riktw/LabPowerSupplyE361xA/README.md

# LabPowerSupplyE361xA
A E3611A based lab power supply with digital controls

More info on the corresponding [blog post.](https://justanotherelectronicsblog.com/?p=846)
