riktw/LabPowerSupplyE361xA/Kicad/Frontpanel/front_schematic.pdf

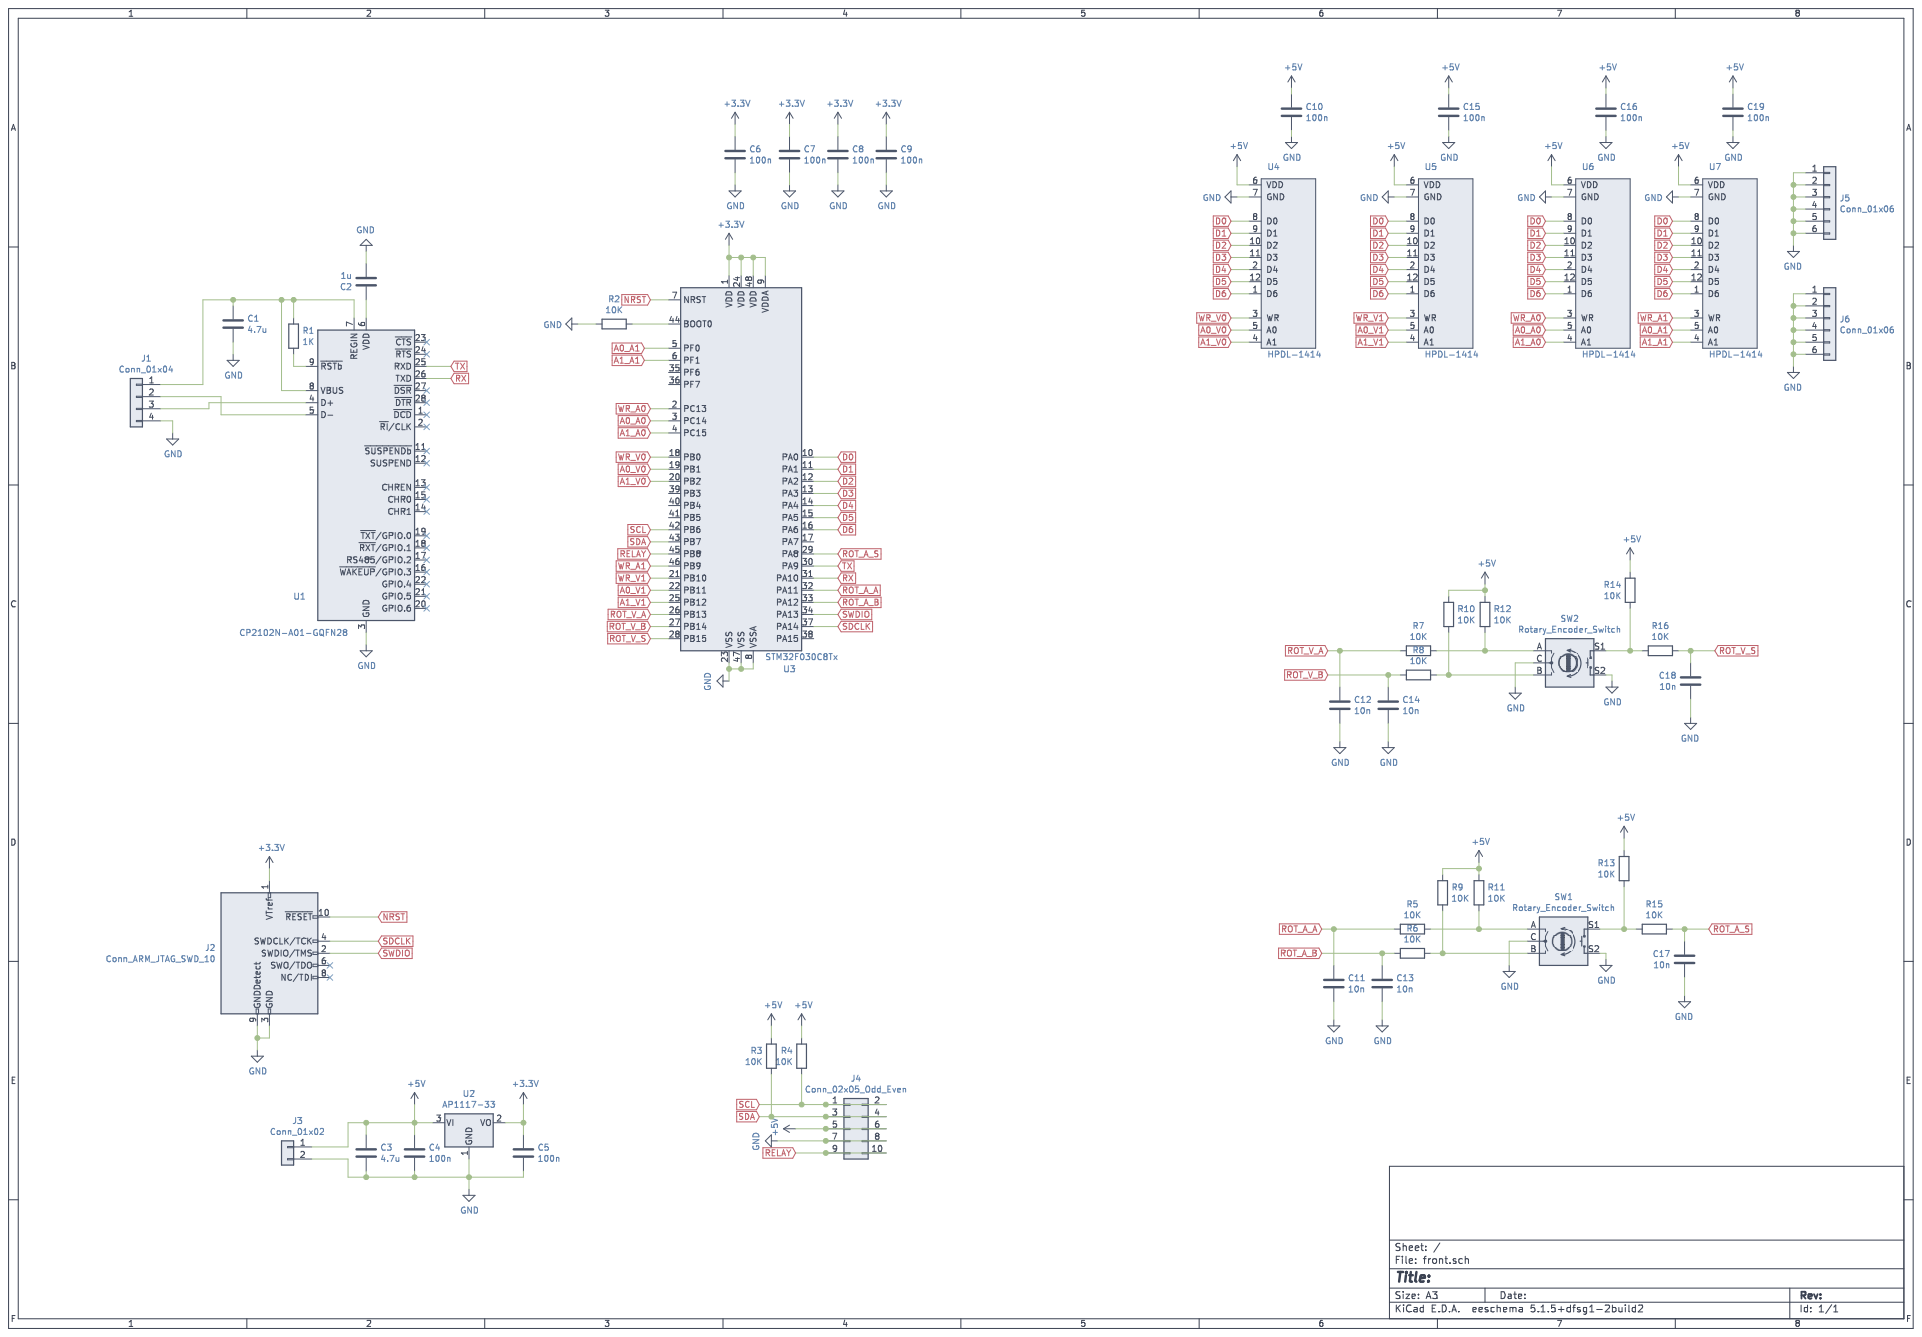
[picture p5: page 1]
