riktw/LabPowerSupplyE361xA/Ltspice/E3610A.asc

C3: cap; 18p
C4: cap; 2.2n
C5: cap; 6.8µ
C6: cap; 220µ
C9: cap; 220p
D1: diode; ES1D
D2: LED; NSCW100
D3: diode; 1N4148
D4: diode; 1N4148
D5: diode; 1N4148
D6: diode; 1N4148
D7: diode; 1N4148
D8: diode; 1N4148
D9: diode; MUR460
D10: LED; NSCW100
I1: current; 10mA
M1: nmos; IRF530
M2: nmos; IRF530
Q3: pnp; 2N3906
R1: res; 0.47
R2: res; 0.47
R3: res; 1K
R4: res; 1k
R5: res; 1k
R6: res; 1K
R7: res; 1k
R8: res; 1.2K
R9: res; 4.7K
R10: res; 1K
R11: res; 5K
R12: res; 1K
R13: res; 500
R14: res; 2.5K
R15: res; 650
R16: res; 3.3K
R17: res; 5k
R18: res; 39K
R19: res; 4.7K
R20: res; 100K
R21: res; 1500K
R22: res; 1
R23: res; 155
R24: res; 560
R25: res; 250
R26: res; 22
R27: res; 1k
R28: res; 1k
R29: res; 1k
R30: res; 0.2
R31: res; 100K
R35: res; 2.5K
R36: res; 50K
R37: res; 2.5K
U1: LT1002
U2: LT1002
U3: LT1002
U4: LT1634-5
U5: LT1002
U6: LT1011
U7: LT1011
V1: voltage; SINE(40 1 100)
V2: voltage; 12
V3: voltage; 12
Named nets: +12, +5, -12, S+, 0
.tran 0 0.1 0 1u
6.8 of 2.2u maakt snelheid anders
CC mode
CV mode
R15, R13, 5K or 10K adj pot
