riktw/LabPowerSupplyE361xA/Ltspice/E3610A_simple.asc

C6: cap; 220µ
D1: diode; ES1D
D3: diode; 1N4148
D4: diode; 1N4148
M1: nmos; IRF530
Q3: pnp; 2N3906
R8: res; 1.2K
R9: res; 4.7K
R12: res; 1K
R16: res; 3.9K
R17: res; 2500
R22: res; 5000
R23: res; 715
R25: res; 2500
R30: res; 0.2
R35: res; 2.5K
R36: res; 50K
R37: res; 2.5K
U1: LT1002
U2: LT1002
U3: LT1002
U4: LT1634-5
U5: LT1002
V1: voltage; SINE(40 1 100)
V2: voltage; 12
V3: voltage; 12
Named nets: +12, -12, 0, OUTPUT, REF5V
.tran 0 0.05 0 1u uic
0-5K for voltage control
0-5K for current control
