riktw/LabPowerSupplyE361xA/Kicad/Frontpanel/front.kicad_pcb

## KiCad design Kicad/Frontpanel/front.kicad_pcb (2021-09-05)

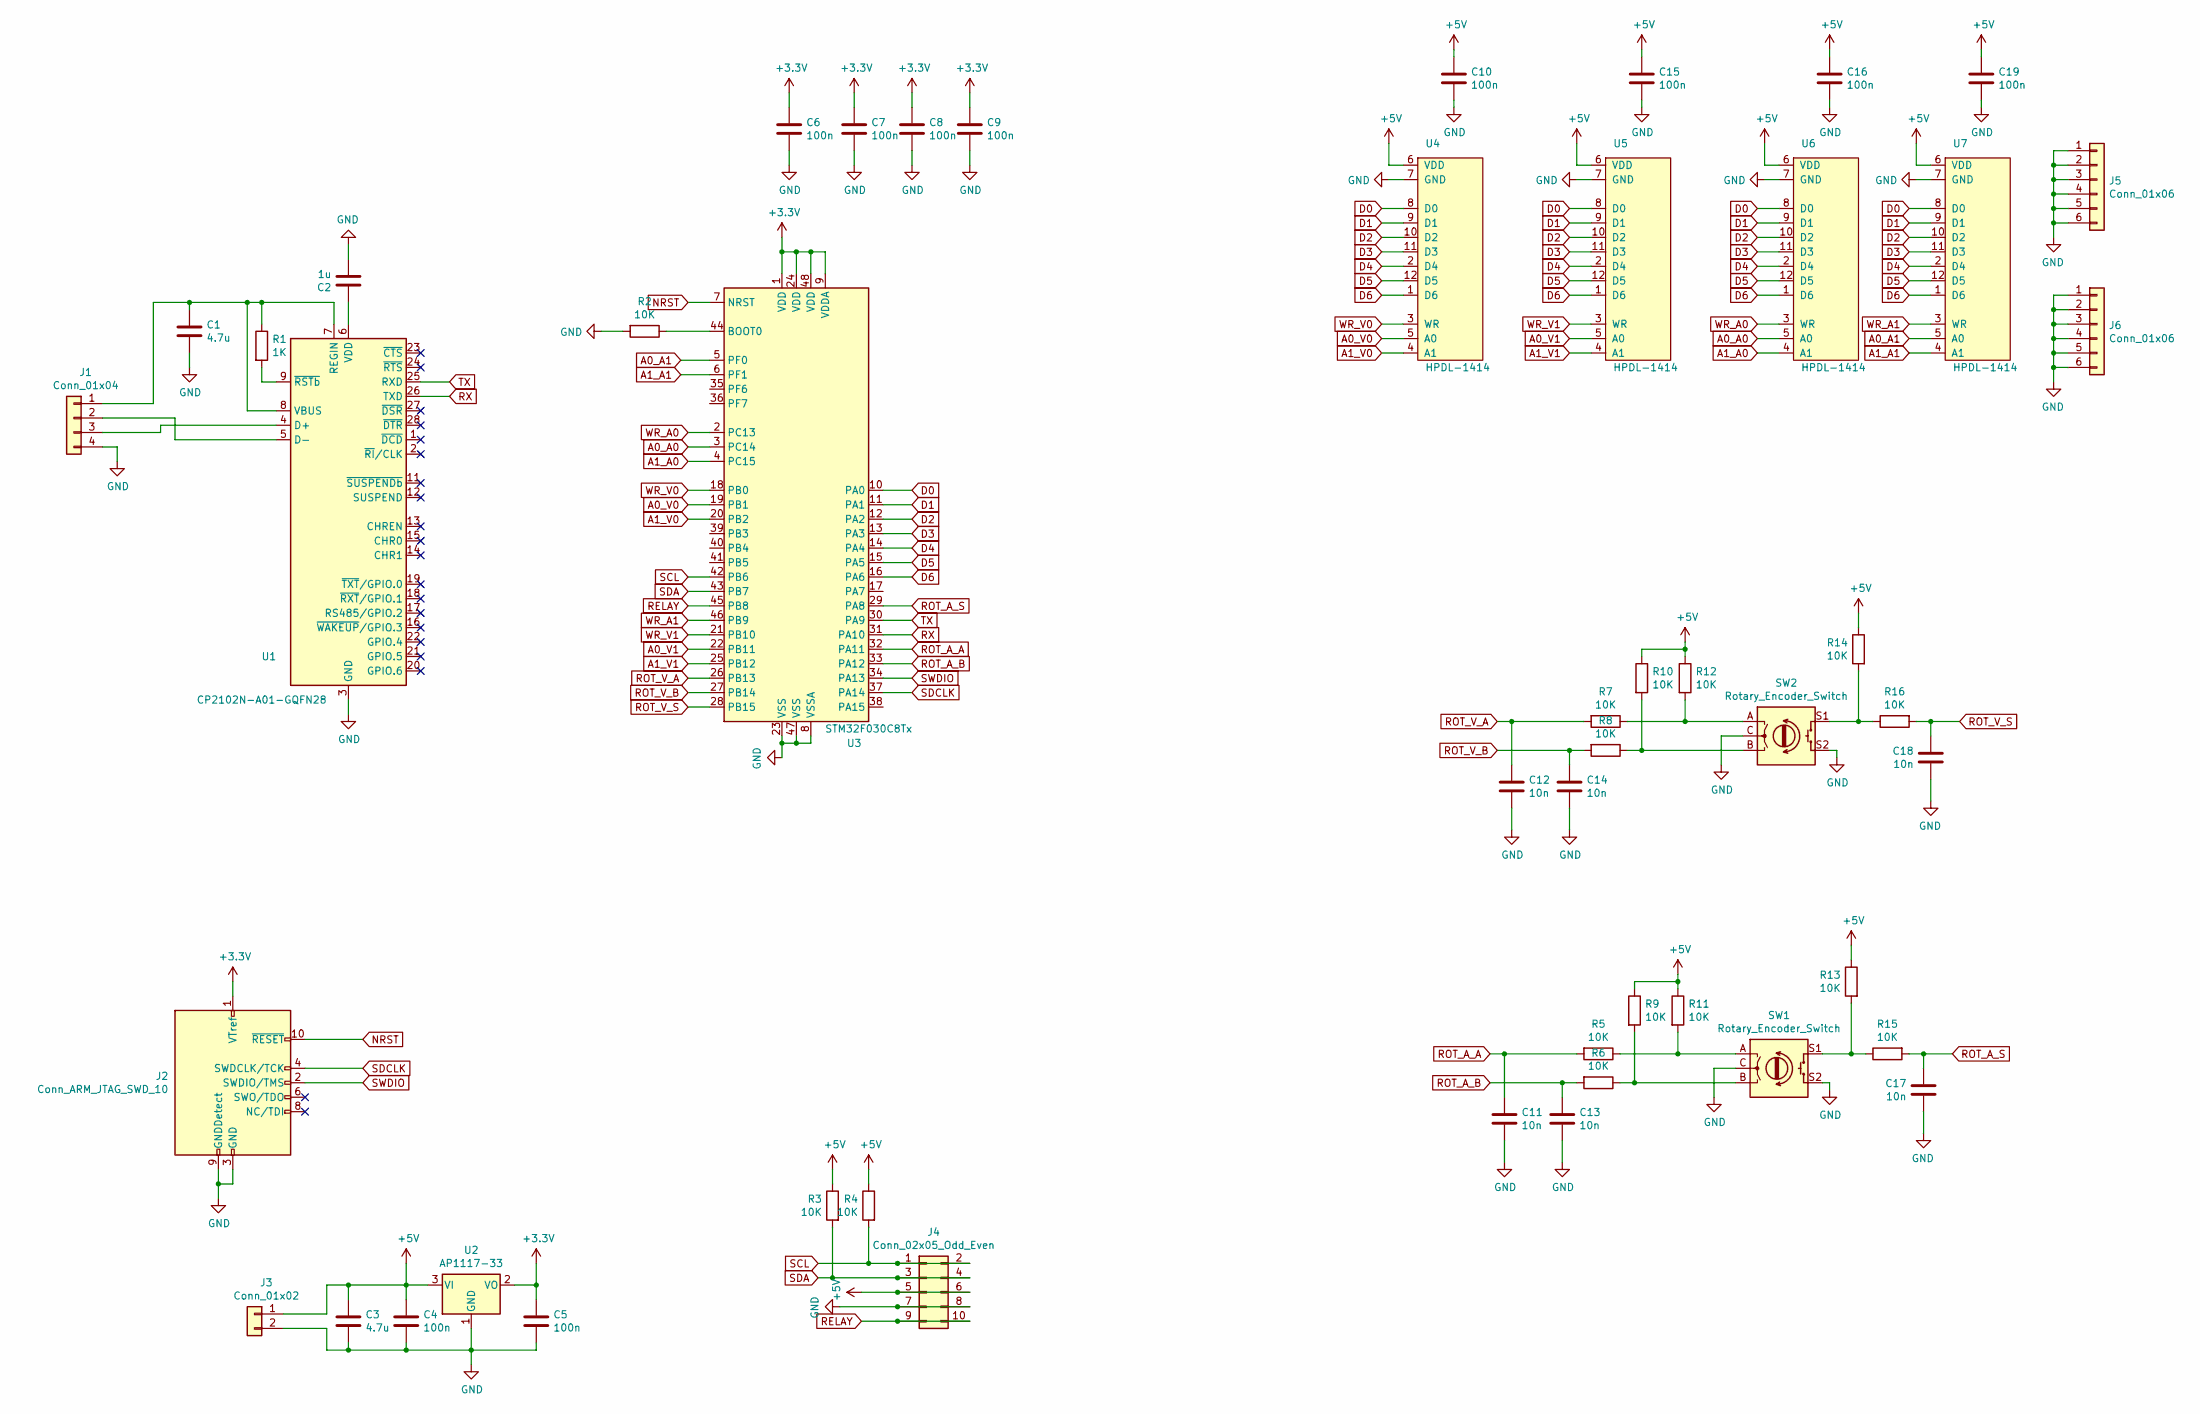
[picture p6: schematic front.sch]

Parts:
C1, C3: 4.7u; C_0603_1608Metric_Pad1.05x0.95mm_HandSolder
C2: 1u; C_0603_1608Metric_Pad1.05x0.95mm_HandSolder
C4, C5, C6, C7, C8, C9, C10, C15, C16, C19: 100n; C_0603_1608Metric_Pad1.05x0.95mm_HandSolder
C11, C12, C13, C14, C17, C18: 10n; C_0603_1608Metric_Pad1.05x0.95mm_HandSolder
J1: Conn_01x04; PinHeader_1x04_P2.54mm_Vertical
J2: Conn_ARM_JTAG_SWD_10; PinHeader_2x05_P1.27mm_Vertical_SMD
J3: Conn_01x02; Wago_734-132_1x02_P3.50mm_Vertical
J4: Conn_02x05_Odd_Even; IDC-Header_2x05_P2.54mm_Vertical
J5, J6: Conn_01x06; PinSocket_1x06_P2.54mm_Vertical
R1: 1K; R_0603_1608Metric_Pad1.05x0.95mm_HandSolder
R2, R3, R4, R5, R6, R7, R8, R9, R10, R11, R12, R13, R14, R15, R16: 10K; R_0603_1608Metric_Pad1.05x0.95mm_HandSolder
SW1, SW2: Rotary_Encoder_Switch; RotaryEncoder_Alps_EC11E-Switch_Vertical_H20mm
U1: CP2102N-A01-GQFN28; QFN-28-1EP_5x5mm_P0.5mm_EP3.35x3.35mm; JLC C6568
U2: AP1117-33; SOT-223-3_TabPin2
U3: STM32F030C8Tx; LQFP-48_7x7mm_P0.5mm
U4, U5, U6, U7: HPDL-1414

Connections:
+3V3: C5.1, C6.1, C7.1, C8.1, C9.1, J2.1 (VTref), U2.2 (VO), U3.1 (VDD), U3.9 (VDDA), U3.24 (VDD), U3.48 (VDD)
+5V: C3.1, C4.1, C10.1, C15.1, C16.1, C19.1, J3.1, J4.5, J4.6, R3.1, R4.1, R9.1, R10.1, R11.1, R12.1, R13.1, R14.1, U2.3 (VI), U4.6 (VDD), U5.6 (VDD), U6.6 (VDD), U7.6 (VDD)
A0_A0: U3.3 (PC14), U6.5 (A0)
A0_A1: U3.5 (PF0), U7.5 (A0)
A0_V0: U3.19 (PB1), U4.5 (A0)
A0_V1: U3.22 (PB11), U5.5 (A0)
A1_A0: U3.4 (PC15), U6.4 (A1)
A1_A1: U3.6 (PF1), U7.4 (A1)
A1_V0: U3.20 (PB2), U4.4 (A1)
A1_V1: U3.25 (PB12), U5.4 (A1)
D0: U3.10 (PA0), U4.8 (D0), U5.8 (D0), U6.8 (D0), U7.8 (D0)
D1: U3.11 (PA1), U4.9 (D1), U5.9 (D1), U6.9 (D1), U7.9 (D1)
D2: U3.12 (PA2), U4.10 (D2), U5.10 (D2), U6.10 (D2), U7.10 (D2)
D3: U3.13 (PA3), U4.11 (D3), U5.11 (D3), U6.11 (D3), U7.11 (D3)
D4: U3.14 (PA4), U4.2 (D4), U5.2 (D4), U6.2 (D4), U7.2 (D4)
D5: U3.15 (PA5), U4.12 (D5), U5.12 (D5), U6.12 (D5), U7.12 (D5)
D6: U3.16 (PA6), U4.1 (D6), U5.1 (D6), U6.1 (D6), U7.1 (D6)
GND: C1.2, C2.2, C3.2, C4.2, C5.2, C6.2, C7.2, C8.2, C9.2, C10.2, C11.2, C12.2, C13.2, C14.2, C15.2, C16.2, C17.2, C18.2, C19.2, J1.4, J2.3 (GND), J2.5 (GND), J2.9 (GNDDetect), J3.2, J4.7, J4.8, J5.1, J5.2, J5.3, J5.4, J5.5, J5.6, J6.1, J6.2, J6.3, J6.4, J6.5, J6.6, R2.2, SW1.C, SW1.S2, SW2.C, SW2.S2, U1.3 (GND), U1.29 (GND), U2.1 (GND), U3.8 (VSSA), U3.23 (VSS), U3.47 (VSS), U4.7 (GND), U5.7 (GND), U6.7 (GND), U7.7 (GND)
NRST: J2.10 (~RESET~), U3.7 (NRST)
unnamed: C1.1, J1.1, R1.1, U1.7 (REGIN), U1.8 (VBUS)
unnamed: C2.1, U1.6 (VDD)
unnamed: J1.2, U1.5 (D-)
unnamed: J1.3, U1.4 (D+)
unnamed: R1.2, U1.9 (~RSTb)
unnamed: R2.1, U3.44 (BOOT0)
unnamed: R6.1, R9.2, SW1.B
unnamed: R8.1, R10.2, SW2.B
unnamed: R5.1, R11.2, SW1.A
unnamed: R7.1, R12.2, SW2.A
unnamed: R13.2, R15.1, SW1.S1
unnamed: R14.2, R16.1, SW2.S1
RELAY: J4.9, J4.10, U3.45 (PB8)
ROT_A_A: C11.1, R5.2, U3.32 (PA11)
ROT_A_B: C13.1, R6.2, U3.33 (PA12)
ROT_A_S: C17.1, R15.2, U3.29 (PA8)
ROT_V_A: C12.1, R7.2, U3.26 (PB13)
ROT_V_B: C14.1, R8.2, U3.27 (PB14)
ROT_V_S: C18.1, R16.2, U3.28 (PB15)
RX: U1.26 (TXD), U3.31 (PA10)
SCL: J4.1, J4.2, R4.2, U3.42 (PB6)
SDA: J4.3, J4.4, R3.2, U3.43 (PB7)
SDCLK: J2.4 (SWDCLK/TCK), U3.37 (PA14)
SWDIO: J2.2 (SWDIO/TMS), U3.34 (PA13)
TX: U1.25 (RXD), U3.30 (PA9)
WR_A0: U3.2 (PC13), U6.3 (WR)
WR_A1: U3.46 (PB9), U7.3 (WR)
WR_V0: U3.18 (PB0), U4.3 (WR)
WR_V1: U3.21 (PB10), U5.3 (WR)

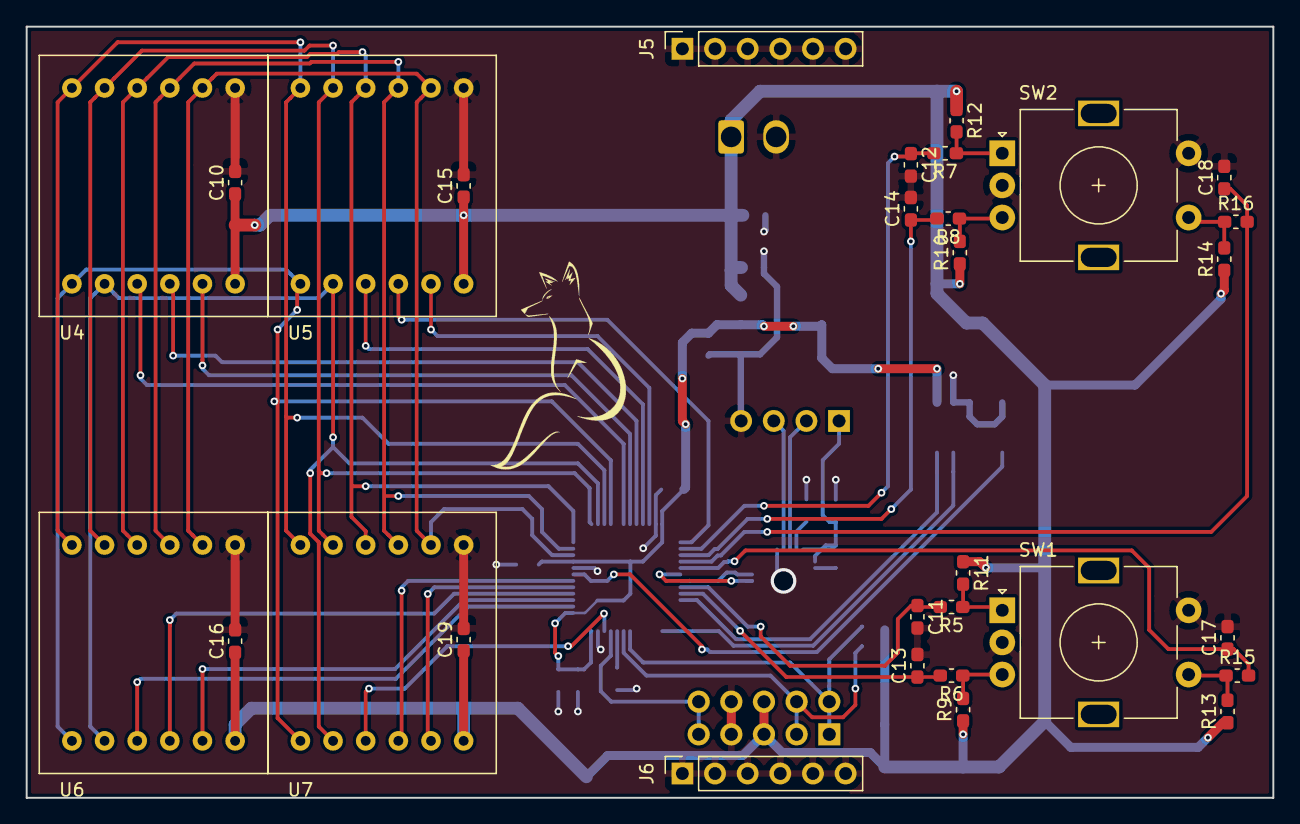
[picture p7: board front.kicad_pcb from above]

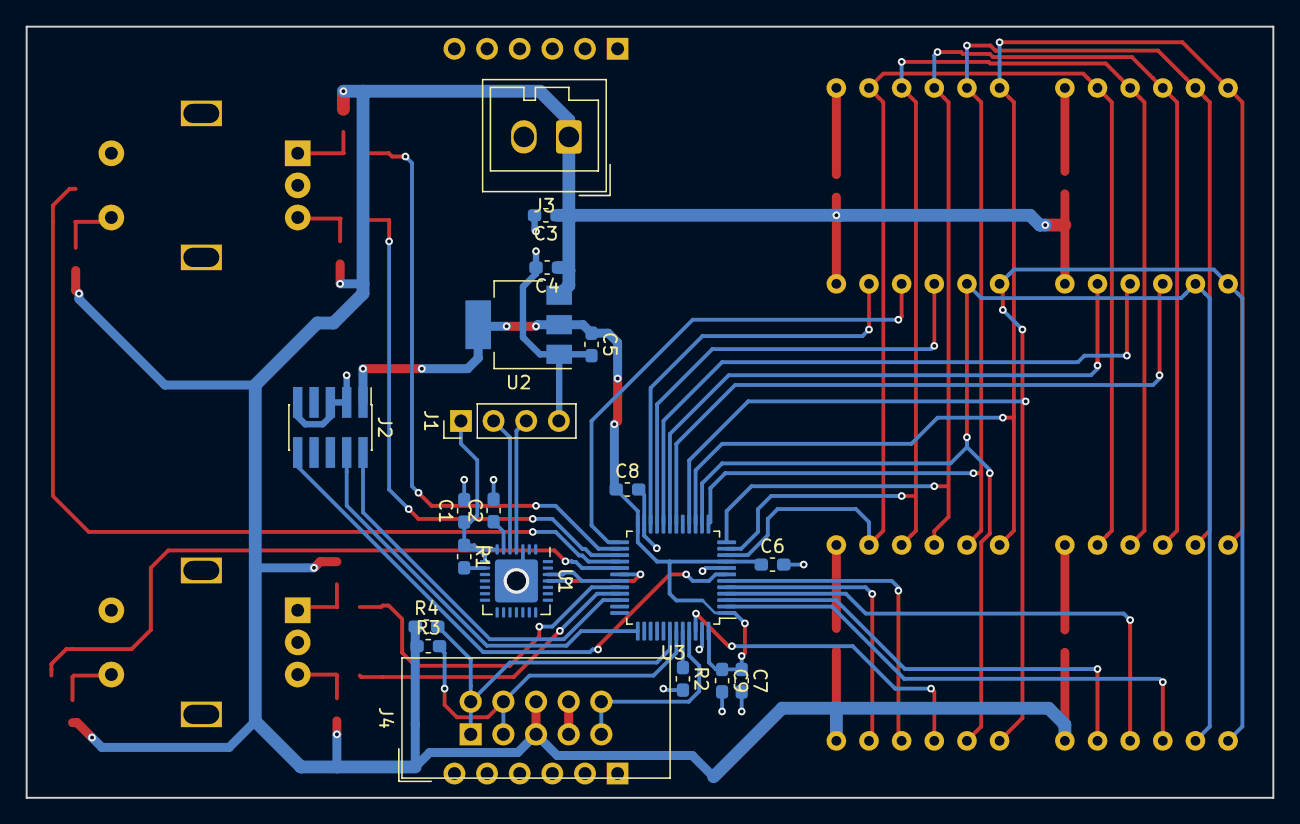
[picture p8: board front.kicad_pcb from below]

Board: 2 copper layers, 97.0 x 60.0 mm, 50 parts (20 on the bottom side), 48 nets.
