riktw/LabPowerSupplyE361xA/Kicad/E3611Abased.kicad_pcb

## KiCad design Kicad/E3611Abased.kicad_pcb (2021-09-05)

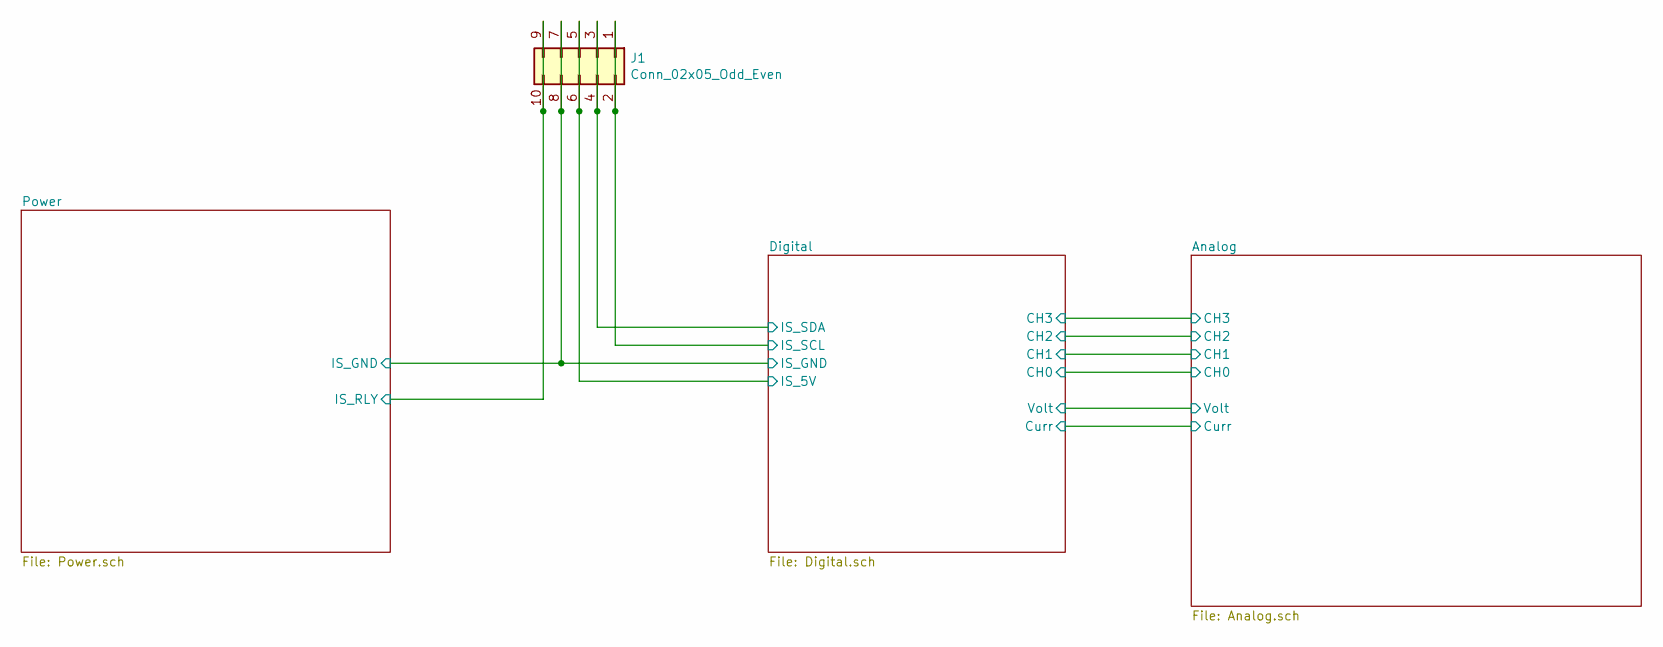
[picture p9: schematic E3611Abased.sch]

Parts:
J1: Conn_02x05_Odd_Even; IDC-Header_2x05_P2.54mm_Vertical

Connections:
/Digital/IS_5V: J1.5, J1.6; also elsewhere on the board
/Digital/IS_GND: J1.7, J1.8; also elsewhere on the board
/Digital/IS_SCL: J1.1, J1.2; also elsewhere on the board
/Digital/IS_SDA: J1.3, J1.4; also elsewhere on the board
/Power/IS_RLY: J1.9, J1.10; also elsewhere on the board

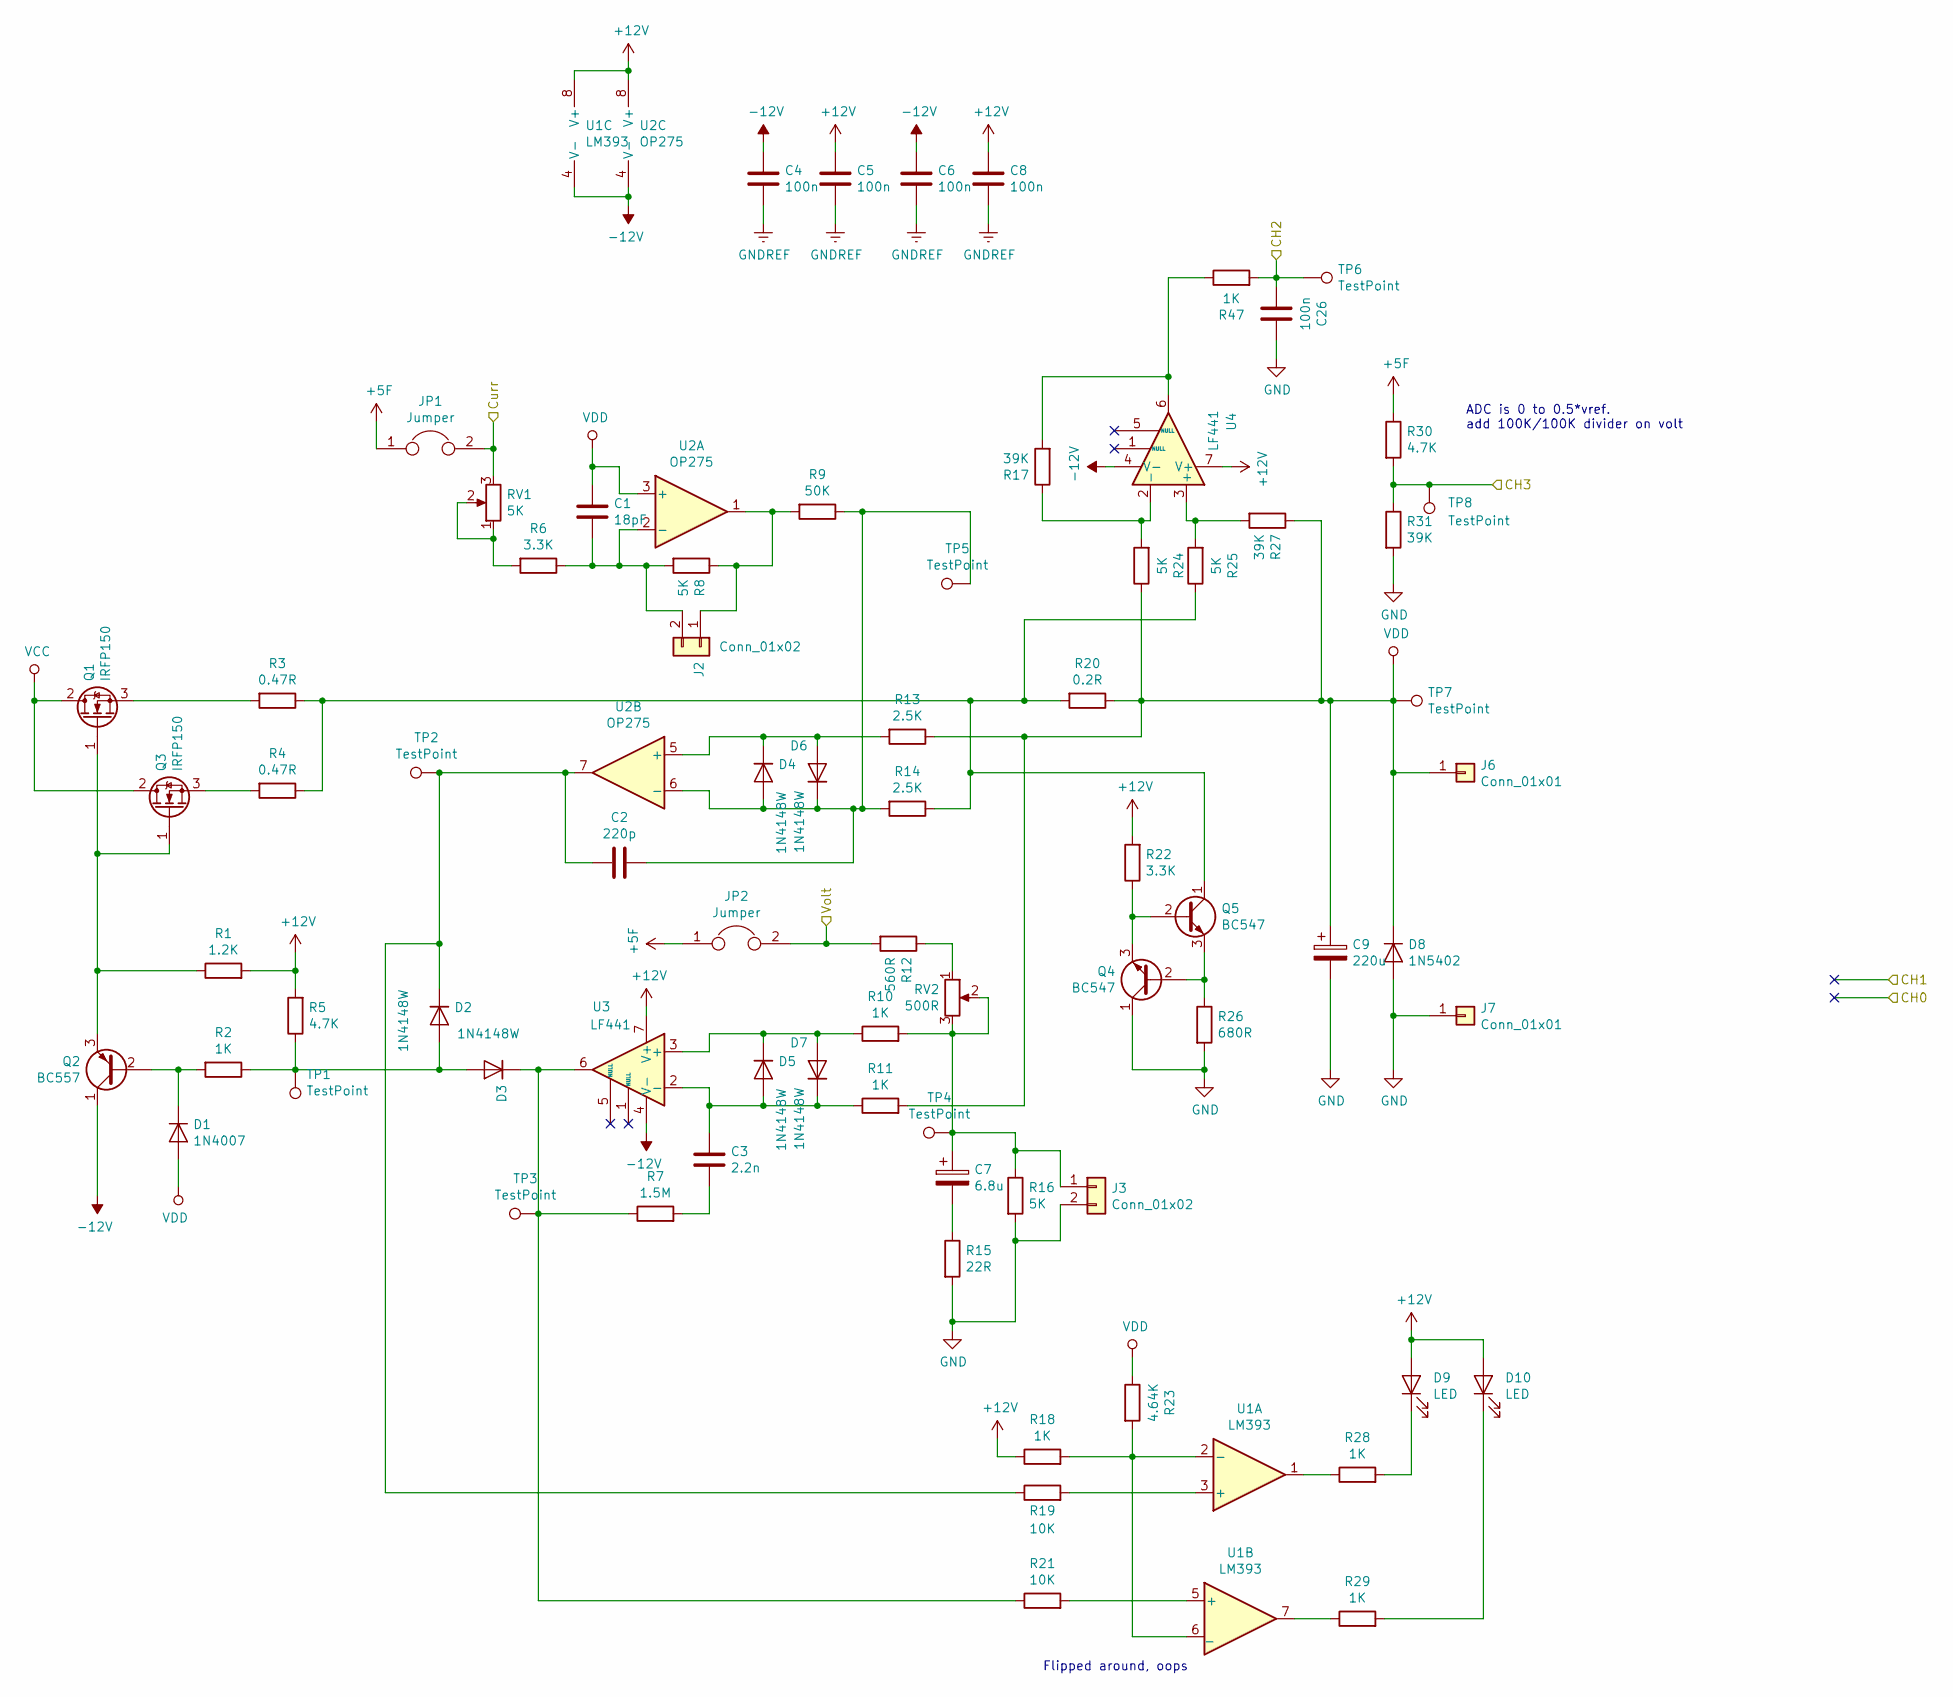
[picture p10: schematic Analog.sch]

Parts:
C1: 18pF; C_0603_1608Metric_Pad1.05x0.95mm_HandSolder
C2: 220p; C_0603_1608Metric_Pad1.05x0.95mm_HandSolder
C3: 2.2n; C_0603_1608Metric_Pad1.05x0.95mm_HandSolder
C4, C5, C6, C8, C26: 100n; C_0603_1608Metric_Pad1.05x0.95mm_HandSolder
C7: 6.8u; CP_Elec_6.3x3
C9: 220u; CP_Radial_D10.0mm_P5.00mm
D1: 1N4007; D_DO-41_SOD81_P10.16mm_Horizontal
D2, D3, D4, D5, D6, D7: 1N4148W; D_SOD-123
D8: 1N5402; D_DO-201AD_P15.24mm_Horizontal
D9, D10: LED; LED_D5.0mm
J2, J3: Conn_01x02; TerminalBlock_Phoenix_MKDS-1,5-2-5.08_1x02_P5.08mm_Horizont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
J6, J7: Conn_01x01; 24.243_Banana_plug
JP1, JP2: Jumper; SolderJumper-2_P1.3mm_Open_Pad1.0x1.5mm
Q1, Q3: IRFP150; TO-247-3_Vertical
Q2: BC557; TO-92_Inline
Q4, Q5: BC547; TO-92_Inline
R1: 1.2K; R_0603_1608Metric_Pad1.05x0.95mm_HandSolder
R2, R10, R11, R18, R28, R29, R47: 1K; R_0603_1608Metric_Pad1.05x0.95mm_HandSolder
R3, R4: 0.47R; R_Axial_DIN0207_L6.3mm_D2.5mm_P15.24mm_Horizontal
R5, R30: 4.7K; R_0603_1608Metric_Pad1.05x0.95mm_HandSolder
R6, R22: 3.3K; R_0603_1608Metric_Pad1.05x0.95mm_HandSolder
R7: 1.5M; R_0603_1608Metric_Pad1.05x0.95mm_HandSolder
R8, R16, R24, R25: 5K; R_0603_1608Metric_Pad1.05x0.95mm_HandSolder
R9: 50K; R_0603_1608Metric_Pad1.05x0.95mm_HandSolder
R12: 560R; R_0603_1608Metric_Pad1.05x0.95mm_HandSolder
R13, R14: 2.5K; R_0603_1608Metric_Pad1.05x0.95mm_HandSolder
R15: 22R; R_0603_1608Metric_Pad1.05x0.95mm_HandSolder
R17, R27, R31: 39K; R_0603_1608Metric_Pad1.05x0.95mm_HandSolder
R19, R21: 10K; R_0603_1608Metric_Pad1.05x0.95mm_HandSolder
R20: 0.2R; R_Axial_DIN0207_L6.3mm_D2.5mm_P15.24mm_Horizontal
R23: 4.64K; R_0603_1608Metric_Pad1.05x0.95mm_HandSolder
R26: 680R; R_0603_1608Metric_Pad1.05x0.95mm_HandSolder
RV1: 5K; Potentiometer_Bourns_3266Y_Vertical
RV2: 500R; Potentiometer_Bourns_3266Y_Vertical
TP1, TP2, TP3, TP4, TP5, TP6, TP7, TP8: TestPoint; TestPoint_Loop_D1.80mm_Drill1.0mm_Beaded
U1: LM393; SOIC-8_3.9x4.9mm_P1.27mm
U2: OP275; SOIC-8_3.9x4.9mm_P1.27mm
U3, U4: LF441; SOIC-8_3.9x4.9mm_P1.27mm

Connections:
+5F: JP1.1, JP2.1, R30.1; also elsewhere on the board
+12V: C5.1, C8.1, D9.2 (A), D10.2 (A), R1.2, R5.2, R18.1, R22.2, U1.8 (V+), U2.8 (V+), U3.7 (V+), U4.7 (V+); also elsewhere on the board
-12V: C4.1, C6.1, Q2.1 (C), U1.4 (V-), U2.4 (V-), U3.4 (V-), U4.4 (V-); also elsewhere on the board
/Analog/CH2: C26.2, R47.2, TP6.1; also elsewhere on the board
/Analog/CH3: R30.2, R31.1, TP8.1; also elsewhere on the board
/Analog/Curr: JP1.2, RV1.3; also elsewhere on the board
/Analog/Volt: JP2.2, R12.2; also elsewhere on the board
GND: C9.2, C26.1, D8.2 (A), J3.2, J7.1, Q4.1 (C), R15.2, R16.2, R26.2, R31.2; also elsewhere on the board
GNDREF: C1.1, C4.2, C5.2, C6.2, C8.2, C9.1, D1.2 (A), D8.1 (K), J6.1, R11.2, R13.1, R20.1, R23.1, R24.1, R27.1, TP7.1, U2.3 (+); also elsewhere on the board
unnamed: C1.2, J2.2, R6.1, R8.2, U2.2 (-)
unnamed: C2.1, D4.2 (A), D6.1 (K), R9.1, R14.2, TP5.1, U2.6 (-)
unnamed: C2.2, D2.1 (K), R19.1, TP2.1, U2.7
unnamed: C3.1, D5.2 (A), D7.1 (K), R11.1, U3.2 (-)
unnamed: C3.2, R7.2
unnamed: C7.1, J3.1, R10.2, R16.1, RV2.2, RV2.3, TP4.1
unnamed: C7.2, R15.1
unnamed: D1.1 (K), Q2.2 (B), R2.2
unnamed: D2.2 (A), D3.2 (A), R2.1, R5.1, TP1.1
unnamed: D3.1 (K), R7.1, R21.1, TP3.1, U3.6
unnamed: D4.1 (K), D6.2 (A), R13.2, U2.5 (+)
unnamed: D5.1 (K), D7.2 (A), R10.1, U3.3 (+)
unnamed: D9.1 (K), R28.2
unnamed: D10.1 (K), R29.2
unnamed: J2.1, R8.1, R9.2, U2.1
unnamed: Q1.1 (G), Q2.3 (E), Q3.1 (G), R1.1
unnamed: Q1.3 (S), R3.2
unnamed: Q3.3 (S), R4.2
unnamed: Q4.2 (B), Q5.3 (E), R26.1
unnamed: Q4.3 (E), Q5.2 (B), R22.1
unnamed: Q5.1 (C), R3.1, R4.1, R14.1, R20.2, R25.1
unnamed: R6.2, RV1.1, RV1.2
unnamed: R12.1, RV2.1
unnamed: R17.1, R24.2, U4.2 (-)
unnamed: R17.2, R47.1, U4.6
unnamed: R18.2, R23.2, U1.2 (-), U1.6 (_)
unnamed: R19.2, U1.3 (+)
unnamed: R21.2, U1.5 (+)
unnamed: R25.2, R27.2, U4.3 (+)
unnamed: R28.1, U1.1
unnamed: R29.1, U1.7
VCC: Q1.2 (D), Q3.2 (D); also elsewhere on the board

Notes on the sheet:
ADC is 0 to 0.5*vref. add 100K/100K divider on volt
Flipped around, oops

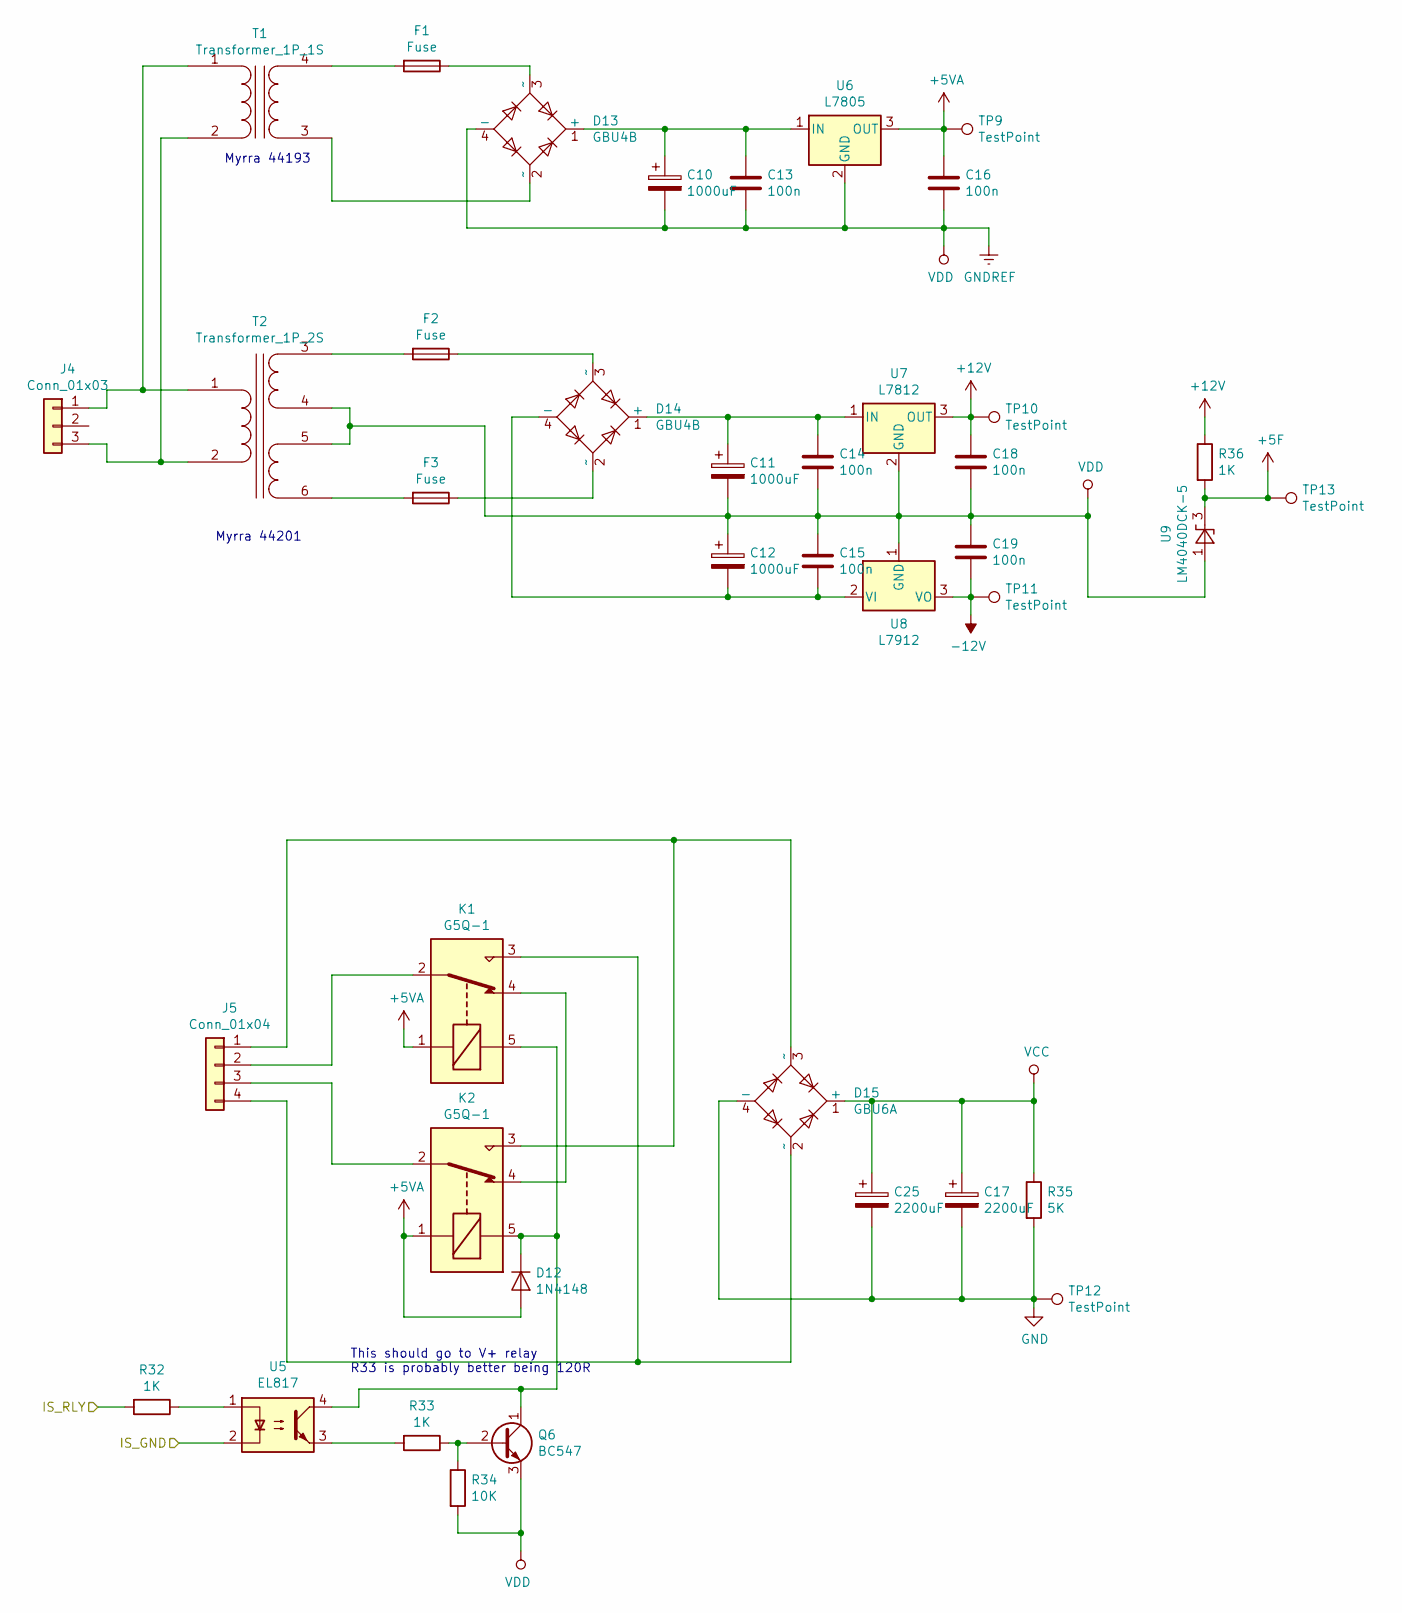
[picture p11: schematic Power.sch]

Parts:
C10, C11, C12: 1000uF; CP_Radial_D10.0mm_P5.00mm
C13, C14, C15, C16, C18, C19: 100n; C_Disc_D5.0mm_W2.5mm_P5.00mm
C17, C25: 2200uF; CP_Radial_D18.0mm_P7.50mm
D12: 1N4148; D_DO-35_SOD27_P7.62mm_Horizontal
D13, D14: GBU4B; Diode_Bridge_Vishay_GBU
D15: GBU6A; Diode_Bridge_Vishay_GBU
F1, F2, F3: Fuse; Fuseholder_Cylinder-5x20mm_Stelvio-Kontek_PTF78_Horizontal_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
J4: Conn_01x03; TerminalBlock_Phoenix_MKDS-1,5-3-5.08_1x03_P5.08mm_Horizont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
J5: Conn_01x04; TerminalBlock_Phoenix_MKDS-1,5-4-5.08_1x04_P5.08mm_Horizont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
K1, K2: G5Q-1; Relay_SPDT_Omron-G5Q-1
Q6: BC547; TO-92_Inline
R32, R33: 1K; R_0603_1608Metric_Pad1.05x0.95mm_HandSolder
R34: 10K; R_0603_1608Metric_Pad1.05x0.95mm_HandSolder
R35: 5K; R_Axial_DIN0414_L11.9mm_D4.5mm_P15.24mm_Horizontal
R36: 1K; R_0603_1608Metric
T1: Transformer_1P_1S; 44XXX_Transformer_3.2VA_Single
T2: Transformer_1P_2S; 44XXX_Transformer_3.2VA
TP9, TP10, TP11, TP12, TP13: TestPoint; TestPoint_Loop_D1.80mm_Drill1.0mm_Beaded
U5: EL817; DIP-4_W7.62mm
U6: L7805; TO-220-3_Vertical
U7: L7812; TO-220-3_Vertical
U8: L7912; TO-220-3_Vertical
U9: LM4040DCK-5; SOT-353_SC-70-5

Connections:
+5F: R36.2, TP13.1, U9.3 (K); also elsewhere on the board
+5VA: C16.1, D12.2 (A), K1.1, K2.1, TP9.1, U6.3 (OUT); also elsewhere on the board
+12V: C18.1, R36.1, TP10.1, U7.3 (OUT); also elsewhere on the board
-12V: C19.2, TP11.1, U8.3 (VO); also elsewhere on the board
/Digital/IS_GND: U5.2; also elsewhere on the board
/Power/IS_RLY: R32.2; also elsewhere on the board
GND: C17.2, C25.2, D15.4 (-), R35.2, TP12.1; also elsewhere on the board
GNDREF: C10.2, C11.2, C12.1, C13.2, C14.2, C15.1, C16.2, C18.2, C19.1, D13.4 (-), Q6.3 (E), R34.2, T2.4 (SB), T2.5 (SC), U6.2 (GND), U7.2 (GND), U8.1 (GND), U9.1 (A); also elsewhere on the board
unnamed: C10.1, C13.1, D13.1 (+), U6.1 (IN)
unnamed: C11.1, C14.1, D14.1 (+), U7.1 (IN)
unnamed: C12.2, C15.2, D14.4 (-), U8.2 (VI)
unnamed: D12.1 (K), K1.5, K2.5, Q6.1 (C), U5.4
unnamed: D13.2 (~~), T1.3 (SA)
unnamed: D13.3 (~~), F1.1
unnamed: D14.2 (~~), F3.1
unnamed: D14.3 (~~), F2.1
unnamed: D15.2 (~~), J5.4, K1.3
unnamed: D15.3 (~~), J5.1, K2.3
unnamed: F1.2, T1.4 (SB)
unnamed: F2.2, T2.3 (SA)
unnamed: F3.2, T2.6 (SD)
unnamed: J4.1, T1.1 (AA), T2.1 (AA)
unnamed: J4.3, T1.2 (AB), T2.2 (AB)
unnamed: J5.2, K1.2
unnamed: J5.3, K2.2
unnamed: K1.4, K2.4
unnamed: Q6.2 (B), R33.1, R34.1
unnamed: R32.1, U5.1
unnamed: R33.2, U5.3
VCC: C17.1, C25.1, D15.1 (+), R35.1; also elsewhere on the board

Notes on the sheet:
Myrra 44201
Myrra 44193
This should go to V+ relay R33 is probably better being 120R

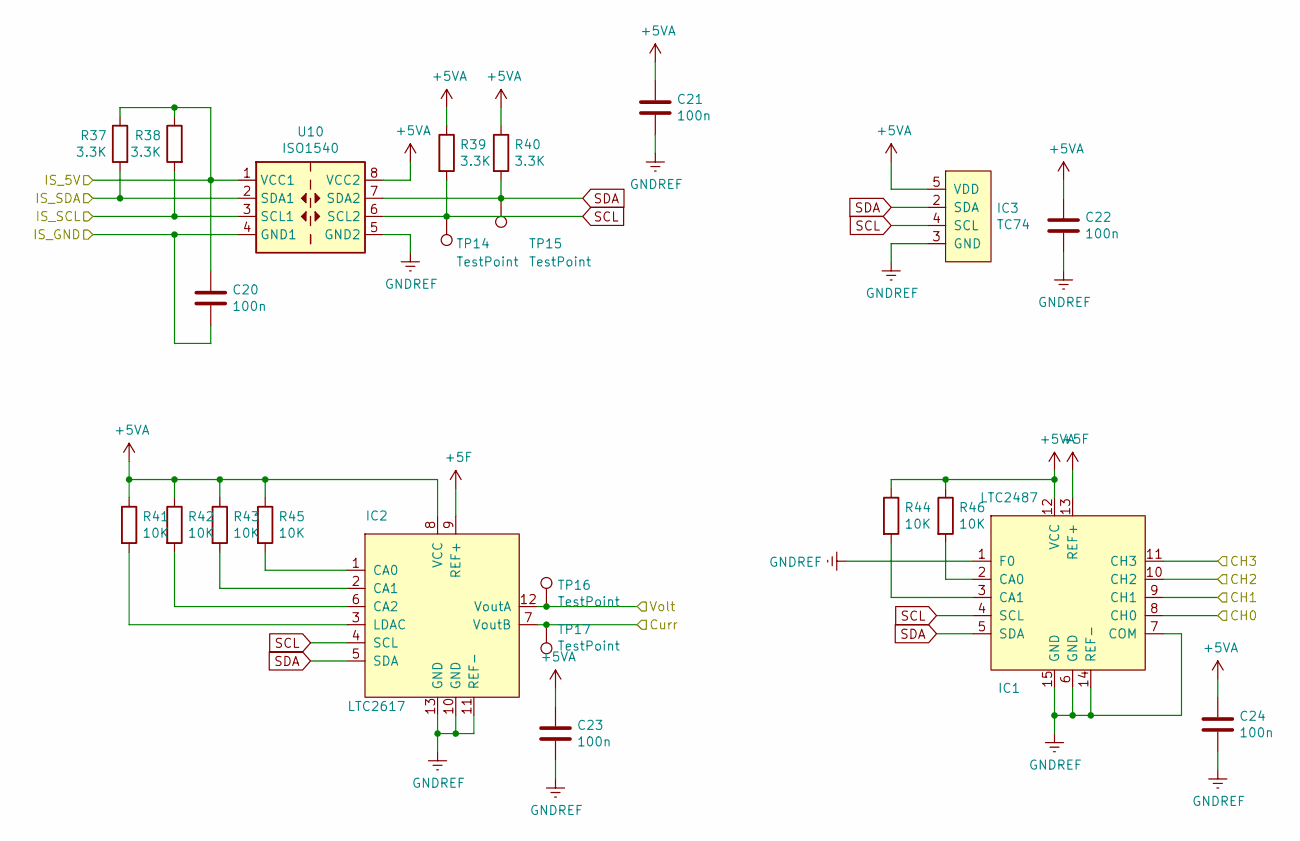
[picture p12: schematic Digital.sch]

Parts:
C20, C21, C22, C23, C24: 100n; C_0603_1608Metric_Pad1.05x0.95mm_HandSolder
IC1: LTC2487; DFN-14-1EP_3x4mm_P0.5mm_EP1.7x3.3mm
IC2: LTC2617; DFN-12-1EP_3x4mm_P0.5mm_EP1.7x3.3mm
IC3: TC74; TO-220-5_Vertical
R37, R38, R39, R40: 3.3K; R_0603_1608Metric
R41, R42, R43, R44, R45, R46: 10K; R_0603_1608Metric
TP14, TP15, TP16, TP17: TestPoint; TestPoint_Loop_D1.80mm_Drill1.0mm_Beaded
U10: ISO1540; SOIC-8_3.9x4.9mm_P1.27mm

Connections:
+5F: IC1.13 (REF+), IC2.9 (REF+); also elsewhere on the board
+5VA: C21.1, C22.1, C23.1, C24.1, IC1.12 (VCC), IC2.8 (VCC), IC3.5 (VDD), R39.1, R40.1, R41.1, R42.1, R43.1, R44.1, R45.1, R46.1, U10.8 (VCC2); also elsewhere on the board
/Analog/CH0: IC1.8 (CH0)
/Analog/CH1: IC1.9 (CH1)
/Analog/CH2: IC1.10 (CH2); also elsewhere on the board
/Analog/CH3: IC1.11 (CH3); also elsewhere on the board
/Analog/Curr: IC2.7 (VoutB), TP17.1; also elsewhere on the board
/Analog/Volt: IC2.12 (VoutA), TP16.1; also elsewhere on the board
/Digital/IS_5V: C20.1, R37.1, R38.1, U10.1 (VCC1); also elsewhere on the board
/Digital/IS_GND: C20.2, U10.4 (GND1); also elsewhere on the board
/Digital/IS_SCL: R38.2, U10.3 (SCL1); also elsewhere on the board
/Digital/IS_SDA: R37.2, U10.2 (SDA1); also elsewhere on the board
GNDREF: C21.2, C22.2, C23.2, C24.2, IC1.1 (F0), IC1.6 (GND), IC1.7 (COM), IC1.14 (REF-), IC1.15 (GND), IC2.10 (GND), IC2.11 (REF-), IC2.13 (GND), IC3.3 (GND), U10.5 (GND2); also elsewhere on the board
unnamed: IC1.2 (CA0), R46.2
unnamed: IC1.3 (CA1), R44.2
unnamed: IC2.1 (CA0), R45.2
unnamed: IC2.2 (CA1), R43.2
unnamed: IC2.3 (LDAC), R41.2
unnamed: IC2.6 (CA2), R42.2
SCL: IC1.4 (SCL), IC2.4 (SCL), IC3.4 (SCL), R39.2, TP14.1, U10.6 (SCL2)
SDA: IC1.5 (SDA), IC2.5 (SDA), IC3.2 (SDA), R40.2, TP15.1, U10.7 (SDA2)

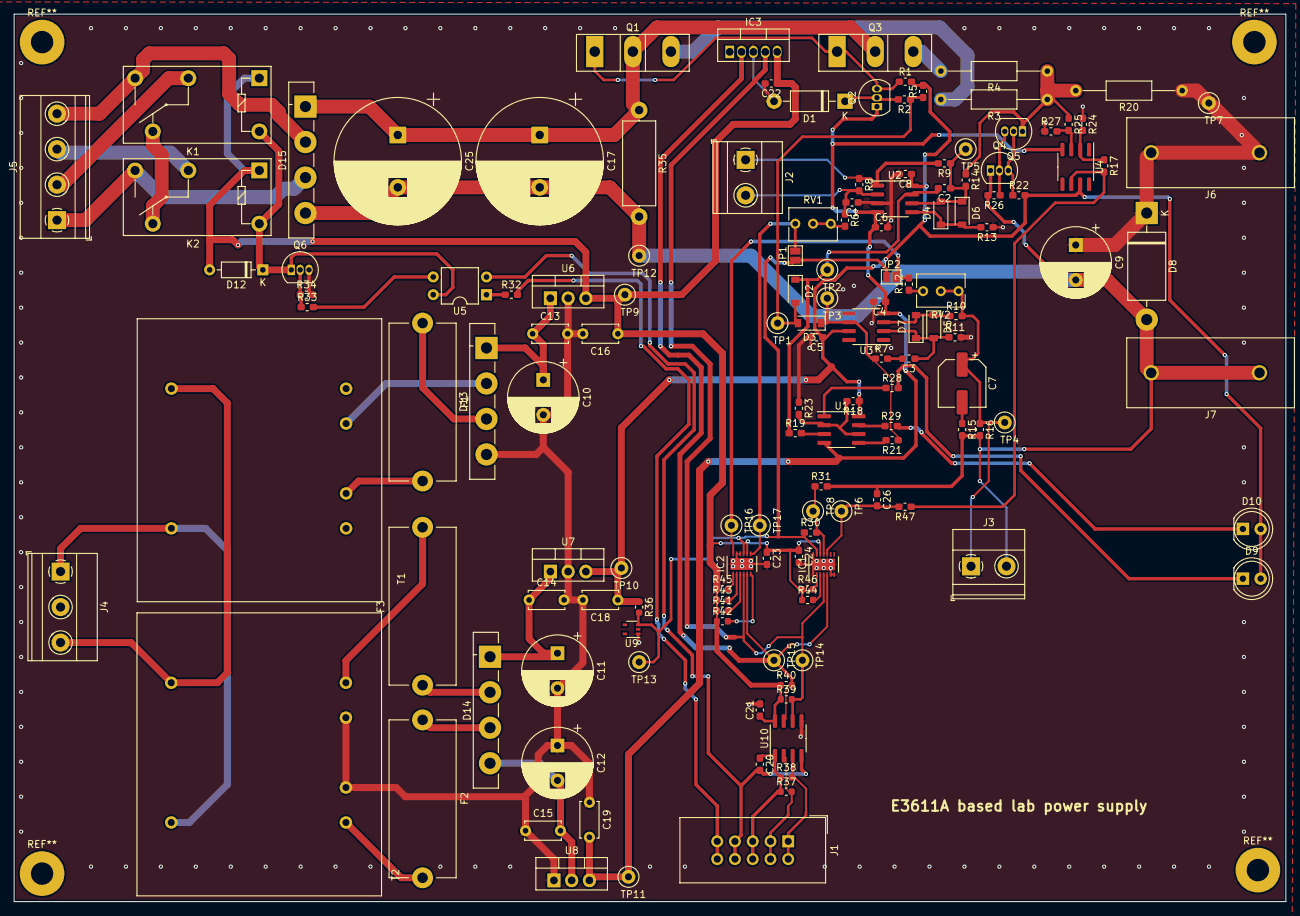
[picture p13: board E3611Abased.kicad_pcb from above]

Board: 2 copper layers, 182.0 x 127.0 mm, 141 parts (0 on the bottom side), 76 nets.
