riktw/LabPowerSupplyE361xA/SW/CPP/Application/Application/start.h

/*
 * start.h
 *
 *  Created on: May 12, 2021
 *      Author: rik
 */

#ifndef APPLICATION_WRAPPER_START_H_
#define APPLICATION_WRAPPER_START_H_


#ifdef __cplusplus
extern "C" {
#endif

void start(void);

#ifdef __cplusplus
}
#endif

#endif /* APPLICATION_WRAPPER_START_H_ */
