riktw/LabPowerSupplyE361xA/(commit log)

2021-02-28 Initial checkin
    [Analog.sch, Digital.sch, E3611Abased.kicad_pcb, E3611Abased.sch, Power.sch]
2021-09-05 fixed bugs in PCB, added frontpanel, added SW for frontpanel
    [Analog.sch, Digital.sch, E3611Abased.kicad_pcb, E3611Abased.sch, Power.sch, front.kicad_pcb, front.sch, frontcutout.kicad_pcb]
